cmdremily/BoronTrident/calibration/stl/Extrusion Multiplier.stl

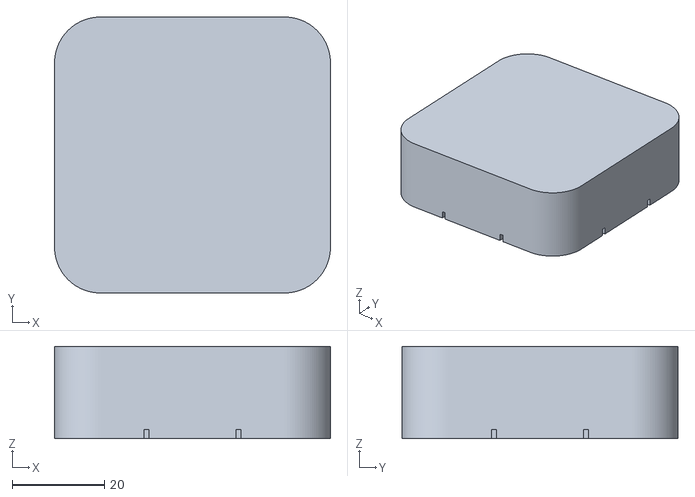
[picture p18: CAD file, 2024-01-06]
calibration/stl/Extrusion Multiplier.stl
60.0 x 60.0 x 20.0
