cmdremily/BoronTrident/e-axis/CW2 Pinda Mount.3mf

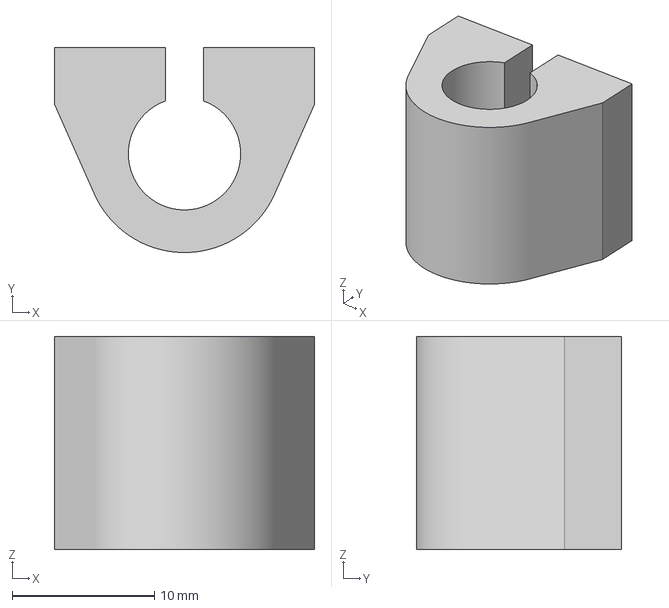
[picture p19: CAD file, 2024-01-06]
e-axis/CW2 Pinda Mount.3mf
18.3 x 14.4 x 15.0 mm
