cmdremily/BoronTrident/motion/umbilical-guide/STL/exhaust_cover.stl

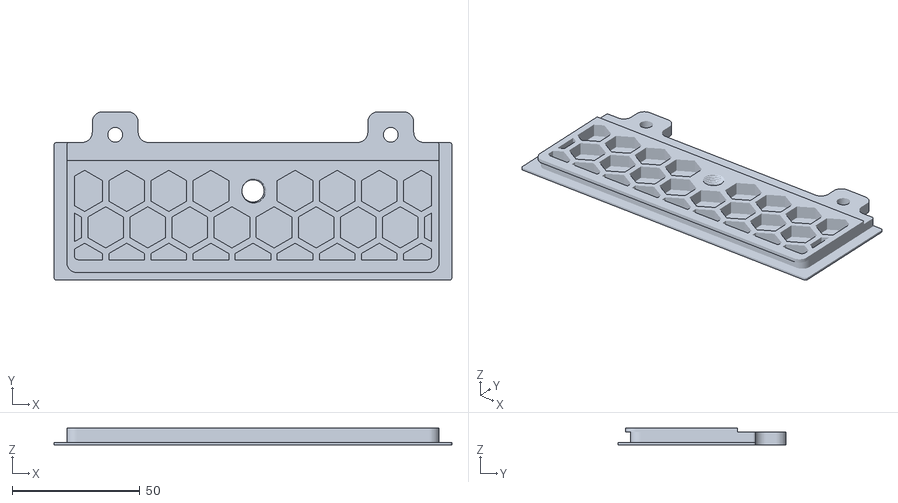
[picture p20: CAD file, 2023-06-08]
motion/umbilical-guide/STL/exhaust_cover.stl
156.0 x 66.0 x 6.62
