cmdremily/BoronTrident/motion/umbilical-motor-mount/STL/[a] Umbilical Mount for A Motor.3mf

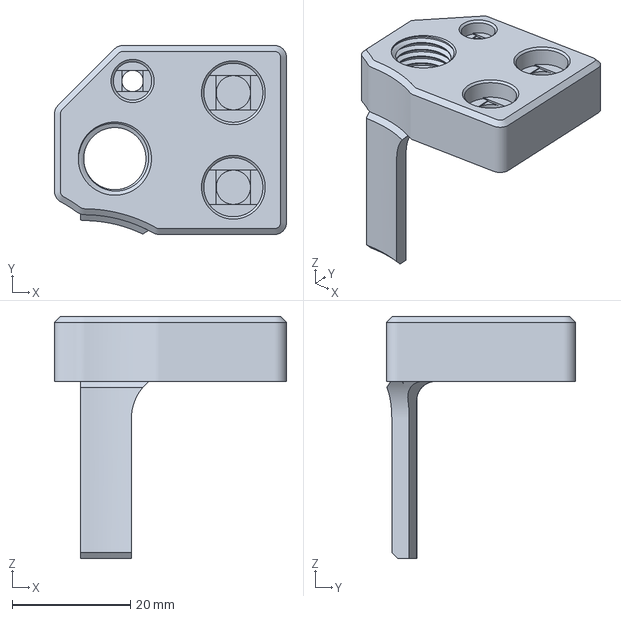
[picture p21: CAD file, 2023-05-30]
motion/umbilical-motor-mount/STL/[a] Umbilical Mount for A Motor.3mf
39.3 x 32.0 x 41.0 mm
