cmdremily/BoronTrident/slicer/Boron Trident 350mm bed.stl

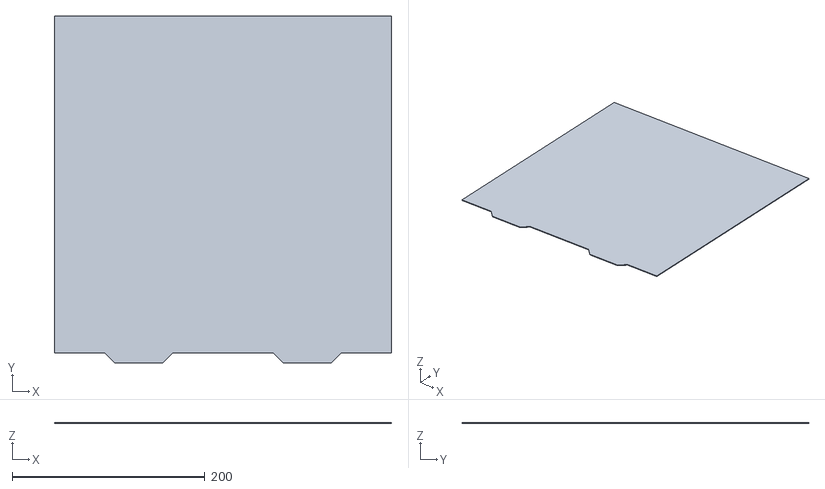
[picture p22: CAD file, 2024-01-06]
slicer/Boron Trident 350mm bed.stl
350.0 x 360.0 x 1.00
