cmdremily/BoronTrident/calibration/stl/AB-Rotation Distance Calibration Model.3mf

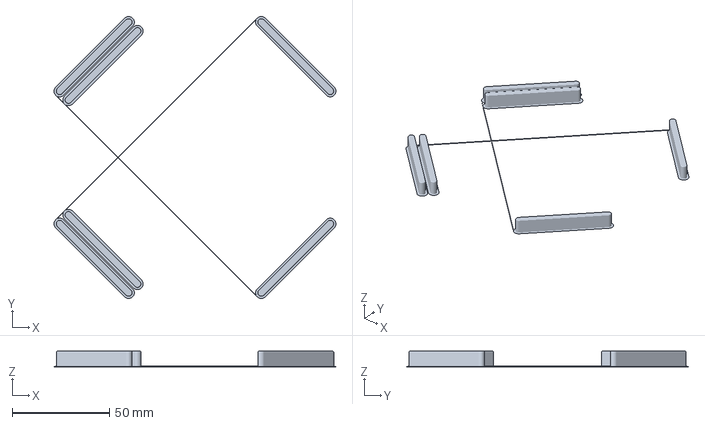
[picture p23: CAD file, 2023-06-25]
calibration/stl/AB-Rotation Distance Calibration Model.3mf
144.8 x 144.8 x 8.00 mm
