cmdremily/BoronTrident/motion/umbilical-guide/STL/[a]_guide_arm.stl

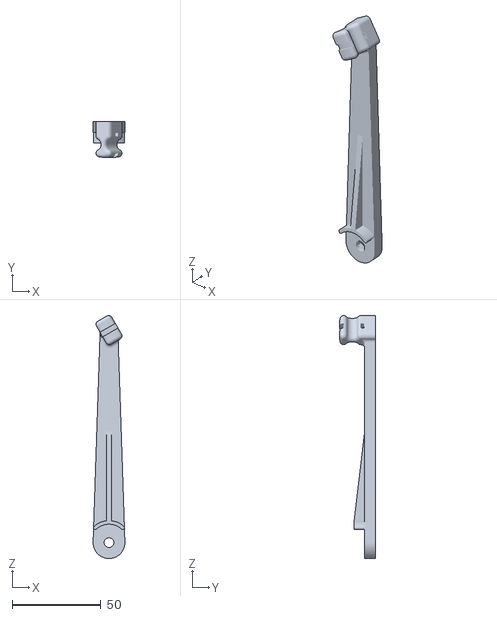
[picture p24: CAD file, 2023-06-08]
motion/umbilical-guide/STL/[a]_guide_arm.stl
18.0 x 20.2 x 137.3
