cmdremily/BoronTrident/calibration/stl/XY Reference Dimensions.stl

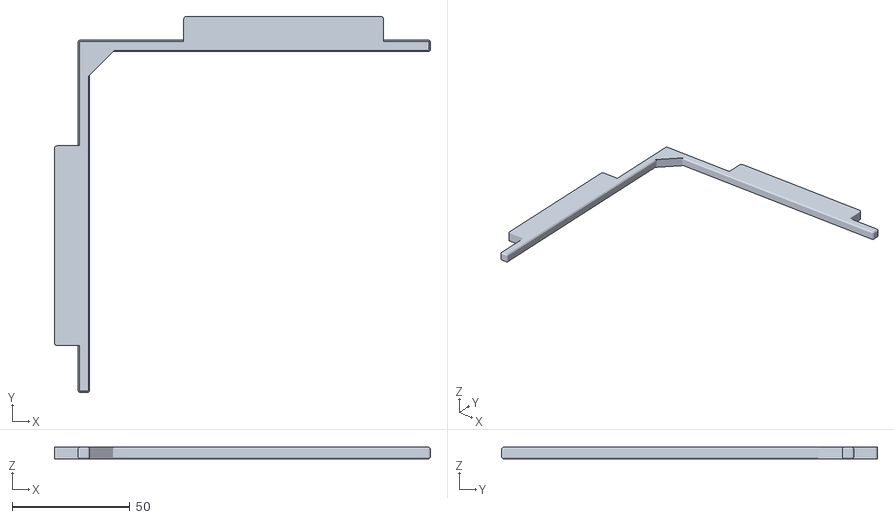
[picture p25: CAD file, 2023-06-17]
calibration/stl/XY Reference Dimensions.stl
160.0 x 160.0 x 5.00
