cmdremily/BoronTrident/motion/umbilical-guide/STL/[a]_guide_mount.stl

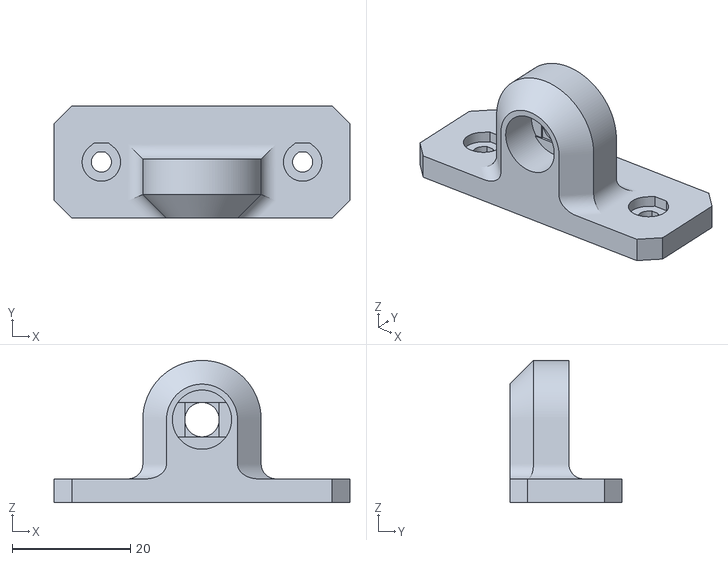
[picture p26: CAD file, 2023-06-08]
motion/umbilical-guide/STL/[a]_guide_mount.stl
50.0 x 19.0 x 24.0
