cmdremily/BoronTrident/motion/umbilical-extruder-mount/STL/[a] EBB36 Mounting Plate.3mf

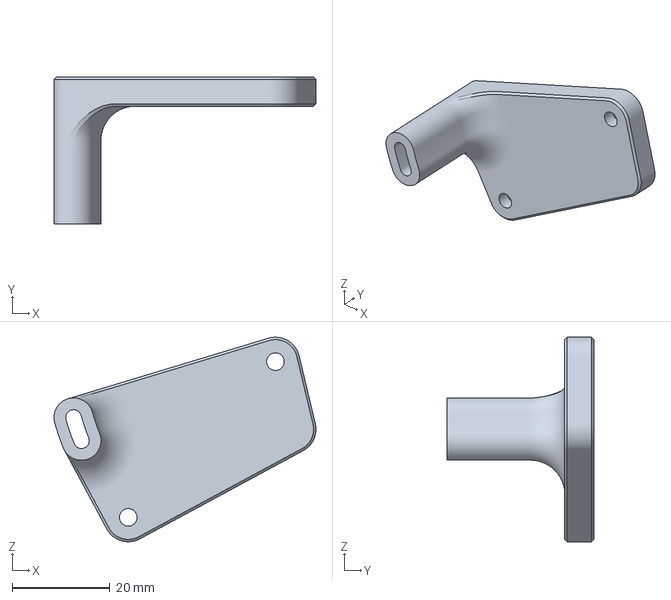
[picture p27: CAD file, 2023-05-30]
motion/umbilical-extruder-mount/STL/[a] EBB36 Mounting Plate.3mf
53.6 x 30.1 x 41.9 mm
