cmdremily/BoronTrident/motion/umbilical-extruder-mount/STL/[a] M3 2.6mm Plastic Washer.3mf

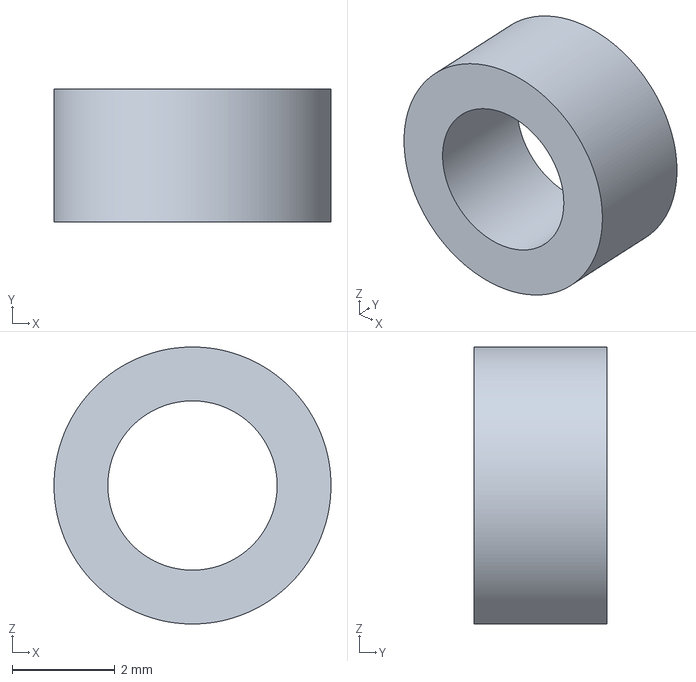
[picture p28: CAD file, 2023-05-30]
motion/umbilical-extruder-mount/STL/[a] M3 2.6mm Plastic Washer.3mf
5.40 x 2.60 x 5.40 mm
