cmdremily/BoronTrident/motion/umbilical-extruder-mount/STL/[a] M3 0.4mm Plastic Washer.3mf

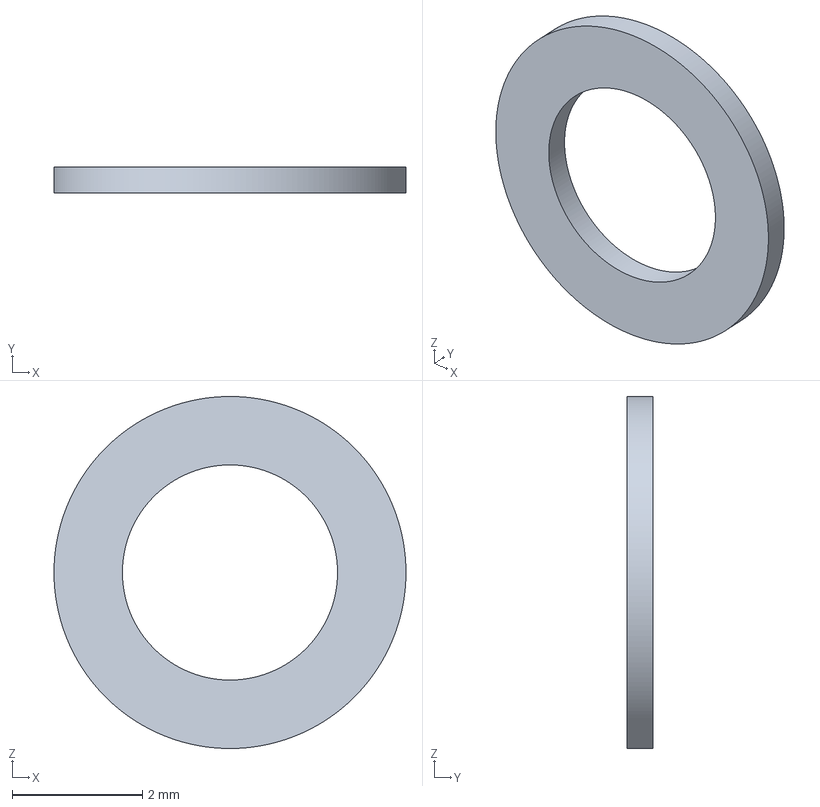
[picture p29: CAD file, 2023-05-30]
motion/umbilical-extruder-mount/STL/[a] M3 0.4mm Plastic Washer.3mf
5.40 x 0.4 x 5.40 mm
