cmdremily/BoronTrident/(list of files, cad)

Other CAD files:
e-axis/boring_extruder/CAD/Boring Extruder v7.f3z
motion/umbilical-guide/CAD/Exhaust and Guide v17.f3z
motion/umbilical-guide/CAD/Exhaust and Guide.f3d
motion/umbilical-guide/CAD/Exhaust and Guide.f3z
