cmdremily/BoronTrident/calibration/images/ab_setup.png

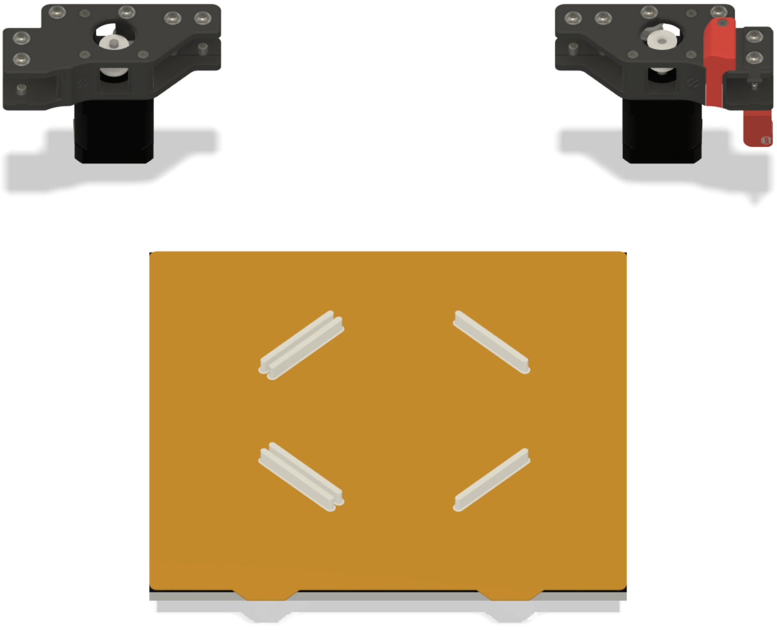
calibration/images/ab_setup.png
