cmdremily/BoronTrident/calibration/README.md

# Calibrating a Boron Trident
The Boron Trident is a machine with a high accuracy, in relative terms for an FDM 3D printer. In order to achieve that, some calibration is necessary.

## Step 0: Prerequisites

To complete all the steps below, you will need to make sure that:

* The printer can print.
* The X-, Y-, Z-, and E-axis have reasonable starting values.
    - See the Voron Trident build documentation.
* You have made a copy of the [Boron Trident Calibration Sheet](https://docs.google.com/spreadsheets/d/12_Dv7_rYfVe8zgUhWrPeNcvSJCttsugQXTOSlCp6MAc).
* Have a pair of digital calipers and a micrometer.
    - A micrometer is required for accurate extrusion multiplier calibration. Without it other methods may be used instead.
* Filament with a very consistent diameter for calibration prints and a profile for it with decent pressure advance calibration.

## Step 1: E-Axis Rotation Distance
Follow [Ellis' Extruder Calibration](https://ellis3dp.com/Print-Tuning-Guide/articles/extruder_calibration.html) procedure but use your digital calipers instead of a ruler. You can chose to use the [Boron Trident Calibration Sheet](https://docs.google.com/spreadsheets/d/12_Dv7_rYfVe8zgUhWrPeNcvSJCttsugQXTOSlCp6MAc) you copied above instead of the one provided by Ellis for convenience.

*N.B. any error in the E-axis `rotation_distance` will be corrected for by per-material extrusion multiplier which you will typically calibrated away anyway. So in a way, this calibration is optional but recommended as having a good value for E-axis allows you to print many materials (less accurately) without calibrating the extrusion multiplier.*

## Step 2: Pressure Advance
Pressure advance needs to be calibrated per filament and nozzle combination.

Follow the steps in [Klipper Pressure Advance](https://www.klipper3d.org/Pressure_Advance.html) and/or [Ellis' Pressure Advance](https://ellis3dp.com/Print-Tuning-Guide/articles/pressure_linear_advance/introduction.html).

## Step 3: Retraction Tuning
Follow the steps in [Ellis Retraction Tuning](https://ellis3dp.com/Print-Tuning-Guide/articles/retraction.html). The goal is to get rid of zits and excessive stringing so that they won't affect the calibration prints.

## Step 4: XY-Axis Rotation Distance
Follow the steps in [XY Calibration](xy-differential-calibration.md).

## Step 5: Z-Axis
Lead screws as used on the Z-axis are accurate enough from the factory that no calibration is needed.

## Step 6: Input Shaper
Follow the steps in [Klipper Measuring Resonances](https://www.klipper3d.org/Measuring_Resonances.html#measuring-the-resonances) or [Klipper Resonance Compensation](https://www.klipper3d.org/Resonance_Compensation.html) if no or unreliable ADXL sensor.

## Step 7: Skew Correction
Follow the steps in [Klipper Skew Correction](https://www.klipper3d.org/Skew_Correction.html).

*Note that it's expected that the skew be very small if step 4 above was done well.*

## Step 8: Material Calibration
For each material and nozzle combination: Follow the steps in [Advanced Material Calibration](adv-material-calibration.md)
