cmdremily/BoronTrident/calibration/images/ab_reference_dimensions.png

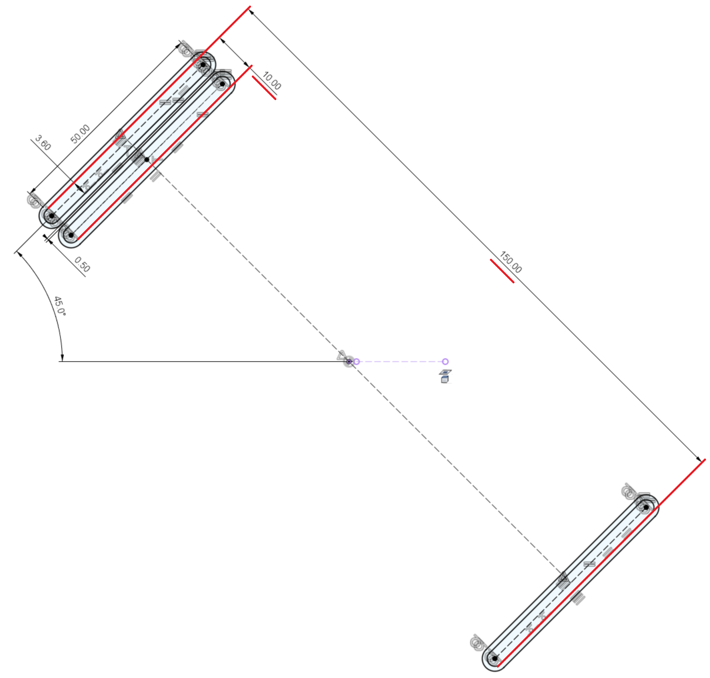
calibration/images/ab_reference_dimensions.png
