cmdremily/BoronTrident/calibration/images/pylons3d.png

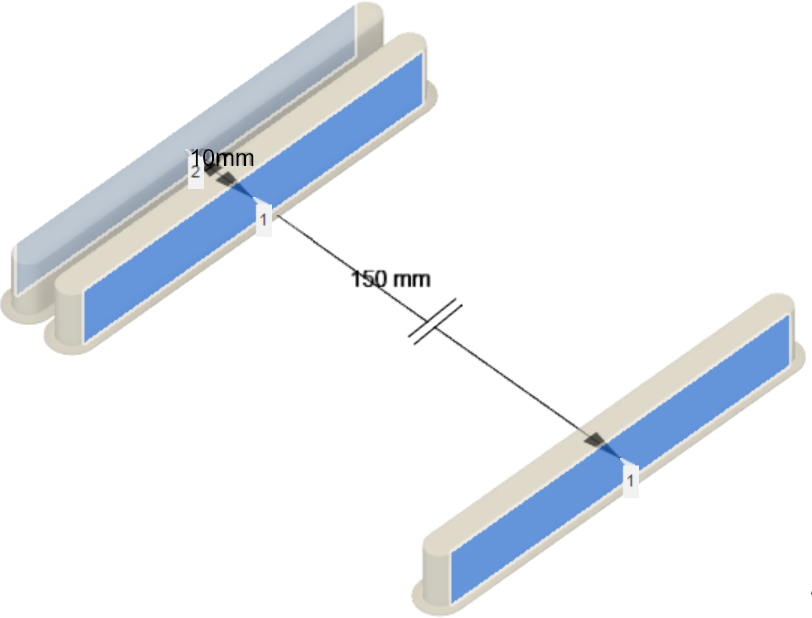
calibration/images/pylons3d.png
