cmdremily/BoronTrident/calibration/images/Seam positions.png

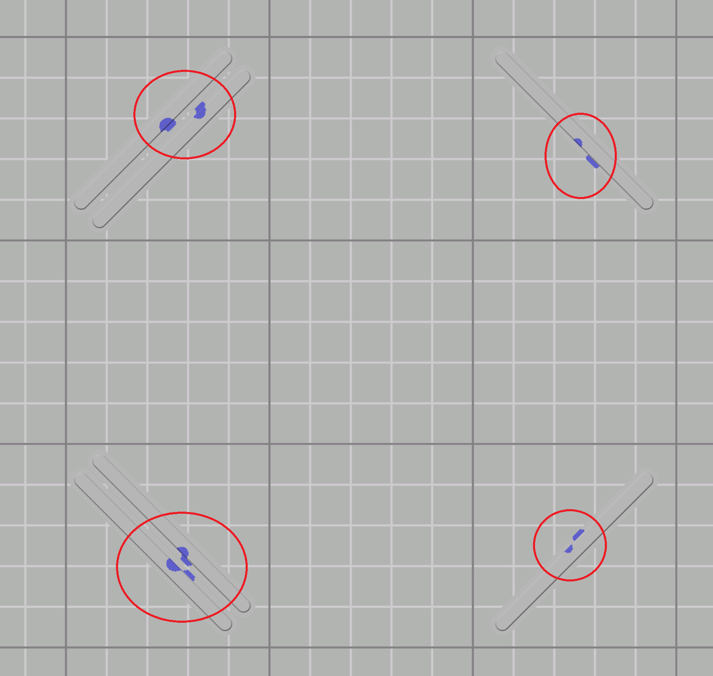
calibration/images/Seam positions.png
