cmdremily/BoronTrident/calibration/images/single extrusion.jpg

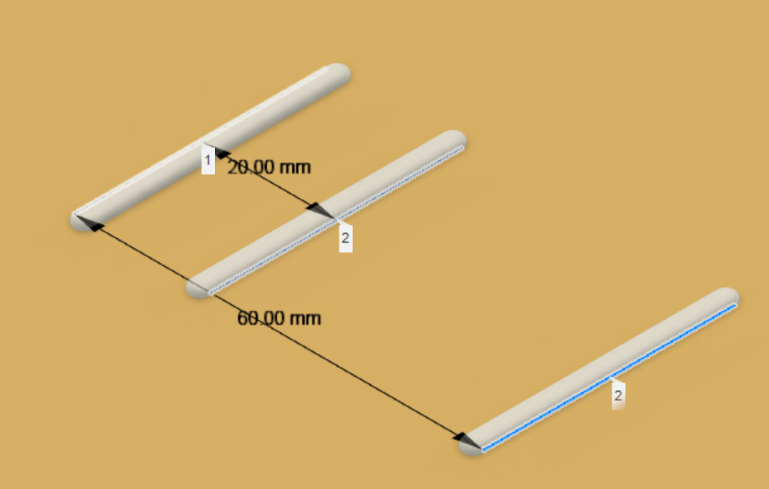
calibration/images/single extrusion.jpg
