cmdremily/BoronTrident/(threads)

Thread 1 (2023-06-02):

Improve Purge Line

cmdremily, 2023-06-02:
Doesn't purge enough in relation to retraction on print complete.

Thread 2 (2023-06-02):

Speed up startup GCODE

cmdremily, 2023-06-02:
There should be some opportunity to go faster. Especially if the bed can be safely dropped by say 10 mm.

We can probably do something like
```
SET_TMC_FIELD STEPPER={params.S} FIELD=diag0_stall VALUE=1 to turn it on, 0 for off.
```
in start print gcode to achieve this. Then we can go faster without fear of crash.

Thread 8 (2023-06-02):

E-motor run current is high since the PTFE swap, try lowering

cmdremily, 2023-06-02:

Thread 9 (2023-06-02):

Implement chamber probe and heat-up macro.

cmdremily, 2023-06-02:

cmdremily, 2023-12-20:
Potentially use MCU temp as chamber temp proxy? It seems like the MCU temp is about 8 K above ambient.

Thread 18 (2023-06-03):

Figure out method of calibrating z-offset for textured sheets.

cmdremily, 2023-06-03:
When setting z-offset of textured sheets, you measure the peak of the texture to the nozzle. But the height of the model when measured is the valley of the texture so there's a constant z-error. Some way of removing this error would be nice.

Notes: Extrusion amount is also not consistent for the first layer height due to the texture.

Thread 20 (2023-06-03):

Improve the exhaust cover

cmdremily, 2023-06-03:
It doesn't positively grip the panel cut-out.

Closed 2023-06-16.

Thread 24 (2023-10-09):

Please can you provide the CAD files so we can contribute to design changes

SirOink, 2023-10-09:
Hey,
I love the project, but there's some changes I'd like to contribute (to the CAN umbilical specifically) but working with STL files in fusion as a non-professional free user is a real pain in the arse.

Any chance you'd be willing to upload either the fusion files or the step files?

If you're worried about these crap Chinese companies stealing things without attribution to the project, you can use a non-commercial license.

Thanks for your great work, I wish it existed when I first self-sourced and built my trident

SirOink, 2023-10-09:
Oh I'm stupid

Closed 2023-10-09.
