cmdremily/BoronTrident/motion/umbilical-guide/images/umbilical-guide-assembly.pdf

5
6

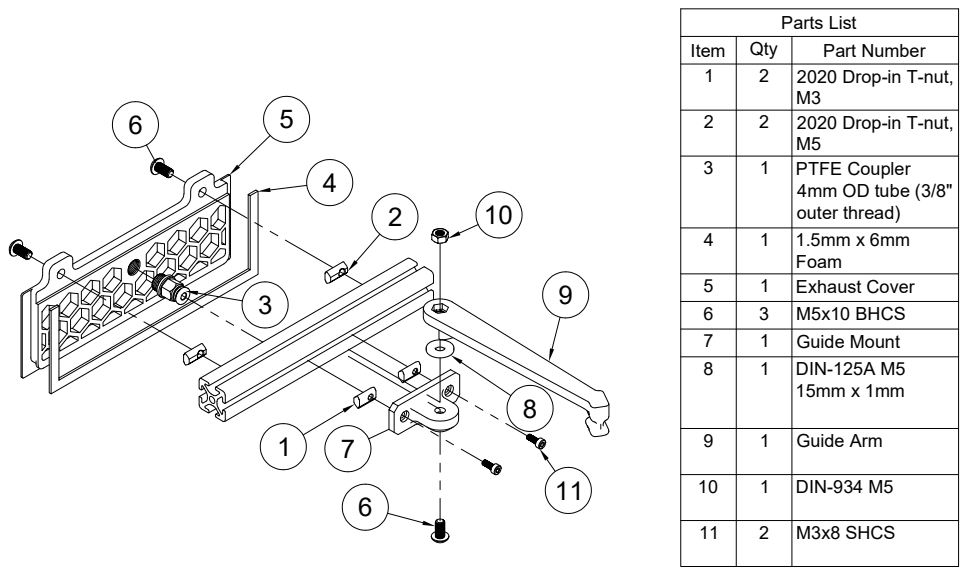
[picture p45: page 1]
Parts List Item; Qty; Part Number 1; 2020 Drop-in T-nut, M3 2; 2020 Drop-in T-nut, M5 3; PTFE Coupler 4mm OD tube (3/8" outer thread); 1.5mm x 6mm Foam; Exhaust Cover 6; M5x10 BHCS 7; Guide Mount 8; DIN-125A M5 15mm x 1mm 9; Guide Arm 10; DIN-934 M5 11; M3x8 SHCS
