cmdremily/BoronTrident/motion/umbilical-extruder-mount/images/Umbilical Extruder Mount - Step 1.pdf

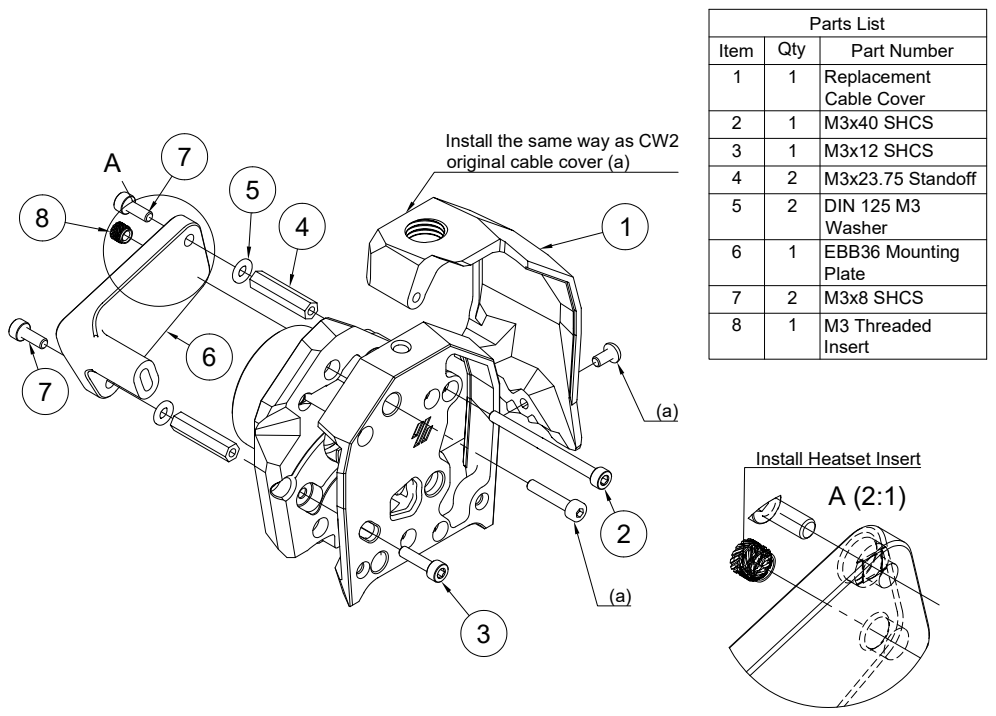
[picture p46: page 1]
Install the same way as CW2 A; original cable cover (a); A (2:1) Parts List Item; Qty; Part Number 1; Replacement Cable Cover 2; M3x40 SHCS 3; M3x12 SHCS 4; M3x23.75 Standoff 5; DIN 125 M3 Washer 6; EBB36 Mounting Plate 7; M3x8 SHCS 8; M3 Threaded Insert 2 3 4 5 7 78; Install Heatset Insert (a) (a)
