cmdremily/BoronTrident/motion/umbilical-extruder-mount/images/Umbilical Extruder Mount - Step 2.pdf

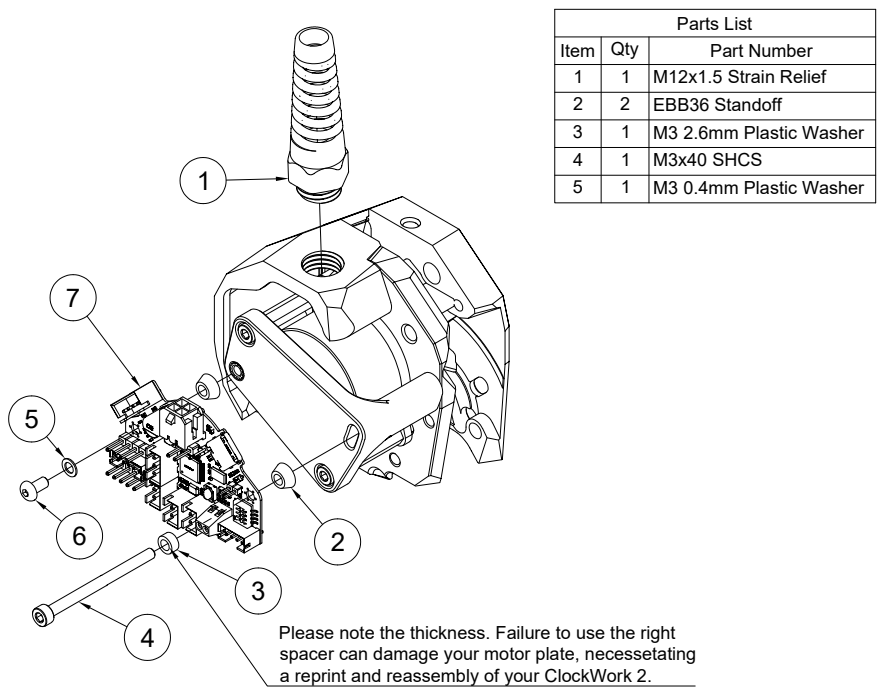
[picture p47: page 1]
Parts List Item; Qty; Part Number 1; M12x1.5 Strain Relief 2; EBB36 Standoff 3; M3 2.6mm Plastic Washer 4; M3x40 SHCS 5; M3 0.4mm Plastic Washer 3 5; 2 Please note the thickness. Failure to use the right spacer can damage your motor plate, necessetating a reprint and reassembly of your ClockWork 2.
