cmdremily/BoronTrident/motion/umbilical-motor-mount/images/umbilical-motor-mount-assemble.pdf

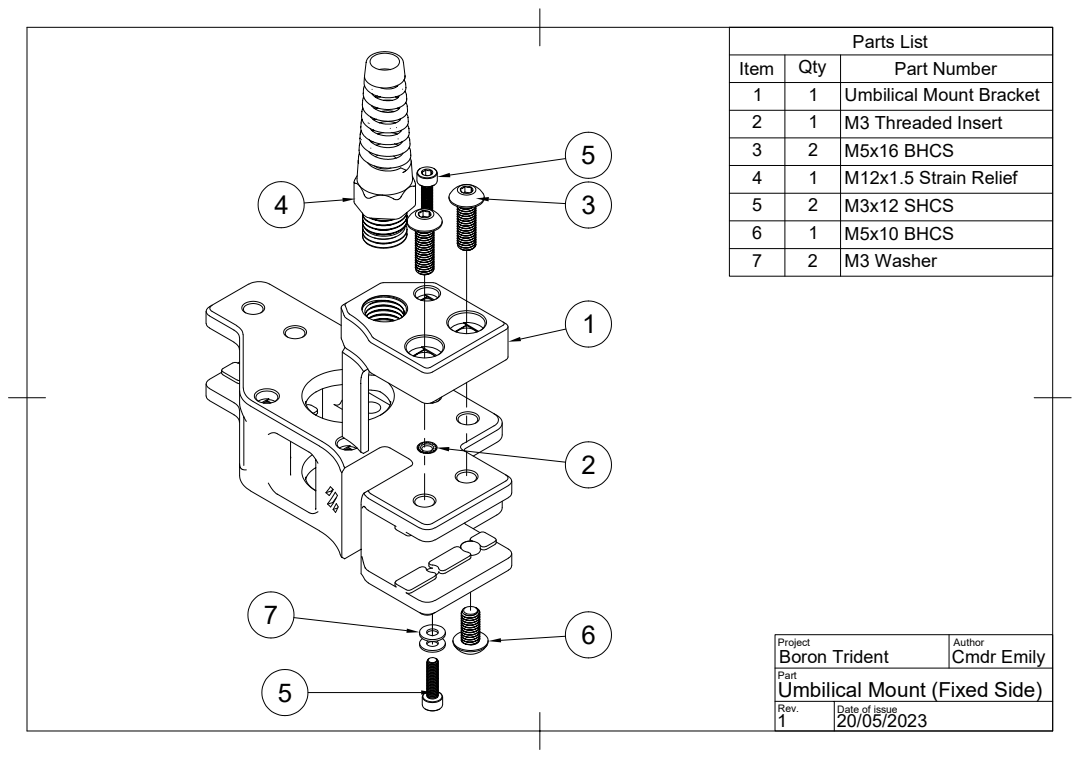
[picture p48: page 1]
Parts List Item; Qty; Part Number 1; Umbilical Mount Bracket 2; M3 Threaded Insert 3; M5x16 BHCS 4; M12x1.5 Strain Relief 5; M3x12 SHCS 6; M5x10 BHCS 7; M3 Washer 6 7; Rev.; Date of issue; Author Cmdr Emily Project Part Umbilical Mount (Fixed Side) 1; 20/05/2023 Boron Trident 5
