cmdremily/BoronTrident/(commit log)

2023-05-30 Initial upload.
    [Replacement Cable Cover.3mf, [a] EBB36 Mounting Plate.3mf, [a] EBB36 Standoff_x2.3mf, [a] M3 0.4mm Plastic Washer.3mf, [a] M3 2.6mm Plastic Washer.3mf, [a] Umbilical Mount for A Motor.3mf]
2023-05-30 Add draft section on selecting cables.
2023-05-31 Correct cable crossection.
2023-06-02 Update cable selection guide with clarification on torsion and USB cable.
2023-06-08 Add umbilical guide mod and update some docs.
    [Boring Extruder v7.f3z, Exhaust and Guide v17.f3z, Exhaust and Guide.f3d, Exhaust and Guide.f3z, [a]_guide_arm.stl, [a]_guide_mount.stl, exhaust_cover.stl]
2023-06-16 Add config.
    [macros.cfg, mainsail.cfg, printer.cfg, sensorless.cfg, toolhead.cfg, xy-motion.cfg, z-motion.cfg]
2023-06-17 Initial draft of XY calibration procedure, still WIP.
    [xy-calibration-model.stl]
2023-06-25 Add guide for calibrating AB rotations.
    [AB-Rotation Distance Calibration Model.3mf]
2023-06-26 Explain how the XY calibration process here is different.
2023-06-26 Add a note on why print settings matter in XY calibration.
2023-06-28 Minor fixes on xy-calibration guide.
2023-06-28 Add a "Why" section to the xy-calibration guide.
2023-07-12 Update donts.md
    Change resistance target to a few hundred ohms based on reports that RS-25-5 has that between the poles from the secondary coil and rectifier network.
2023-07-31 Update configs.
    [macros.cfg, mainsail.cfg, printer.cfg, sensorless.cfg, toolhead.cfg, xy-motion.cfg, z-motion.cfg]
2023-08-09 Update donts.md
    Added a couple things that have come up recently (interpretation of 0L and the like readings, and suggesting re-powering without attempting to clear a power fault may be a bad idea)
2024-01-02 Update configs with adaptive mesh size and chamber heating.
    [filament.cfg, homing.cfg, macros.cfg, positions.cfg, print-bed.cfg, printer.cfg, start-stop.cfg, testing.cfg]
2024-01-02 Fix some bugs with new print start gcode.
    [start-stop.cfg]
2024-01-06 Major update, consolidating my scattered documents, updating calibration procedures and general fixes
    [Boron Trident 350mm bed.stl, CW2 Pinda Mount.3mf, Extrusion Multiplier.stl, XY Reference Dimensions.stl]
2024-01-06 Minor fixes on the shrinkage calibration doc.
2024-02-17 Update the XY calibration text to be more to the point and better structured.
2024-02-17 Update the adv. mat. calibration text to be more to the point and better structured.
2024-02-18 Fix some issues with the config files, and update the material calibration page with example results.
2024-05-03 Add filament macros and improve start-stop logic.
    [filament.cfg, homing.cfg, positions.cfg, print-bed.cfg, printer.cfg, start-stop.cfg, toolhead.cfg]
2024-06-16 Fix move out of range error at end of print. Apparently the bed-mesh offset causes the final move to exceed the Z axis limit when moved to the extreme.
    [filament.cfg, positions.cfg, print-bed.cfg, start-stop.cfg]
2024-11-03 Update configs to latest production.
    [macros.cfg, sensorless.cfg, start-stop.cfg, toolhead.cfg, z-motion.cfg]
